cecilsmith/PIC24_Scale/docs/3d/Scale_Lid.obj

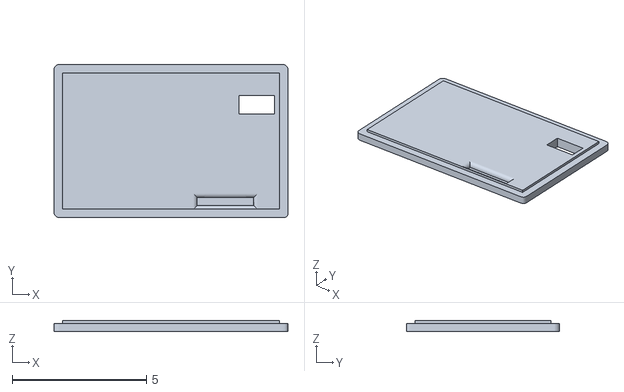
[picture p4: CAD file, 2025-05-07]
docs/3d/Scale_Lid.obj
8.70 x 5.70 x 0.4
