cecilsmith/PIC24_Scale/docs/3d/Scale_Box.obj

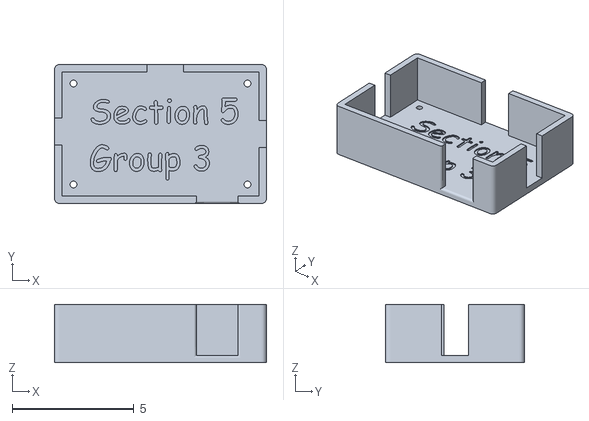
[picture p5: CAD file, 2025-05-07]
docs/3d/Scale_Box.obj
8.70 x 5.70 x 2.40
