cecilsmith/PIC24_Scale/docs/EE3951W_Scale_Schematic.pdf

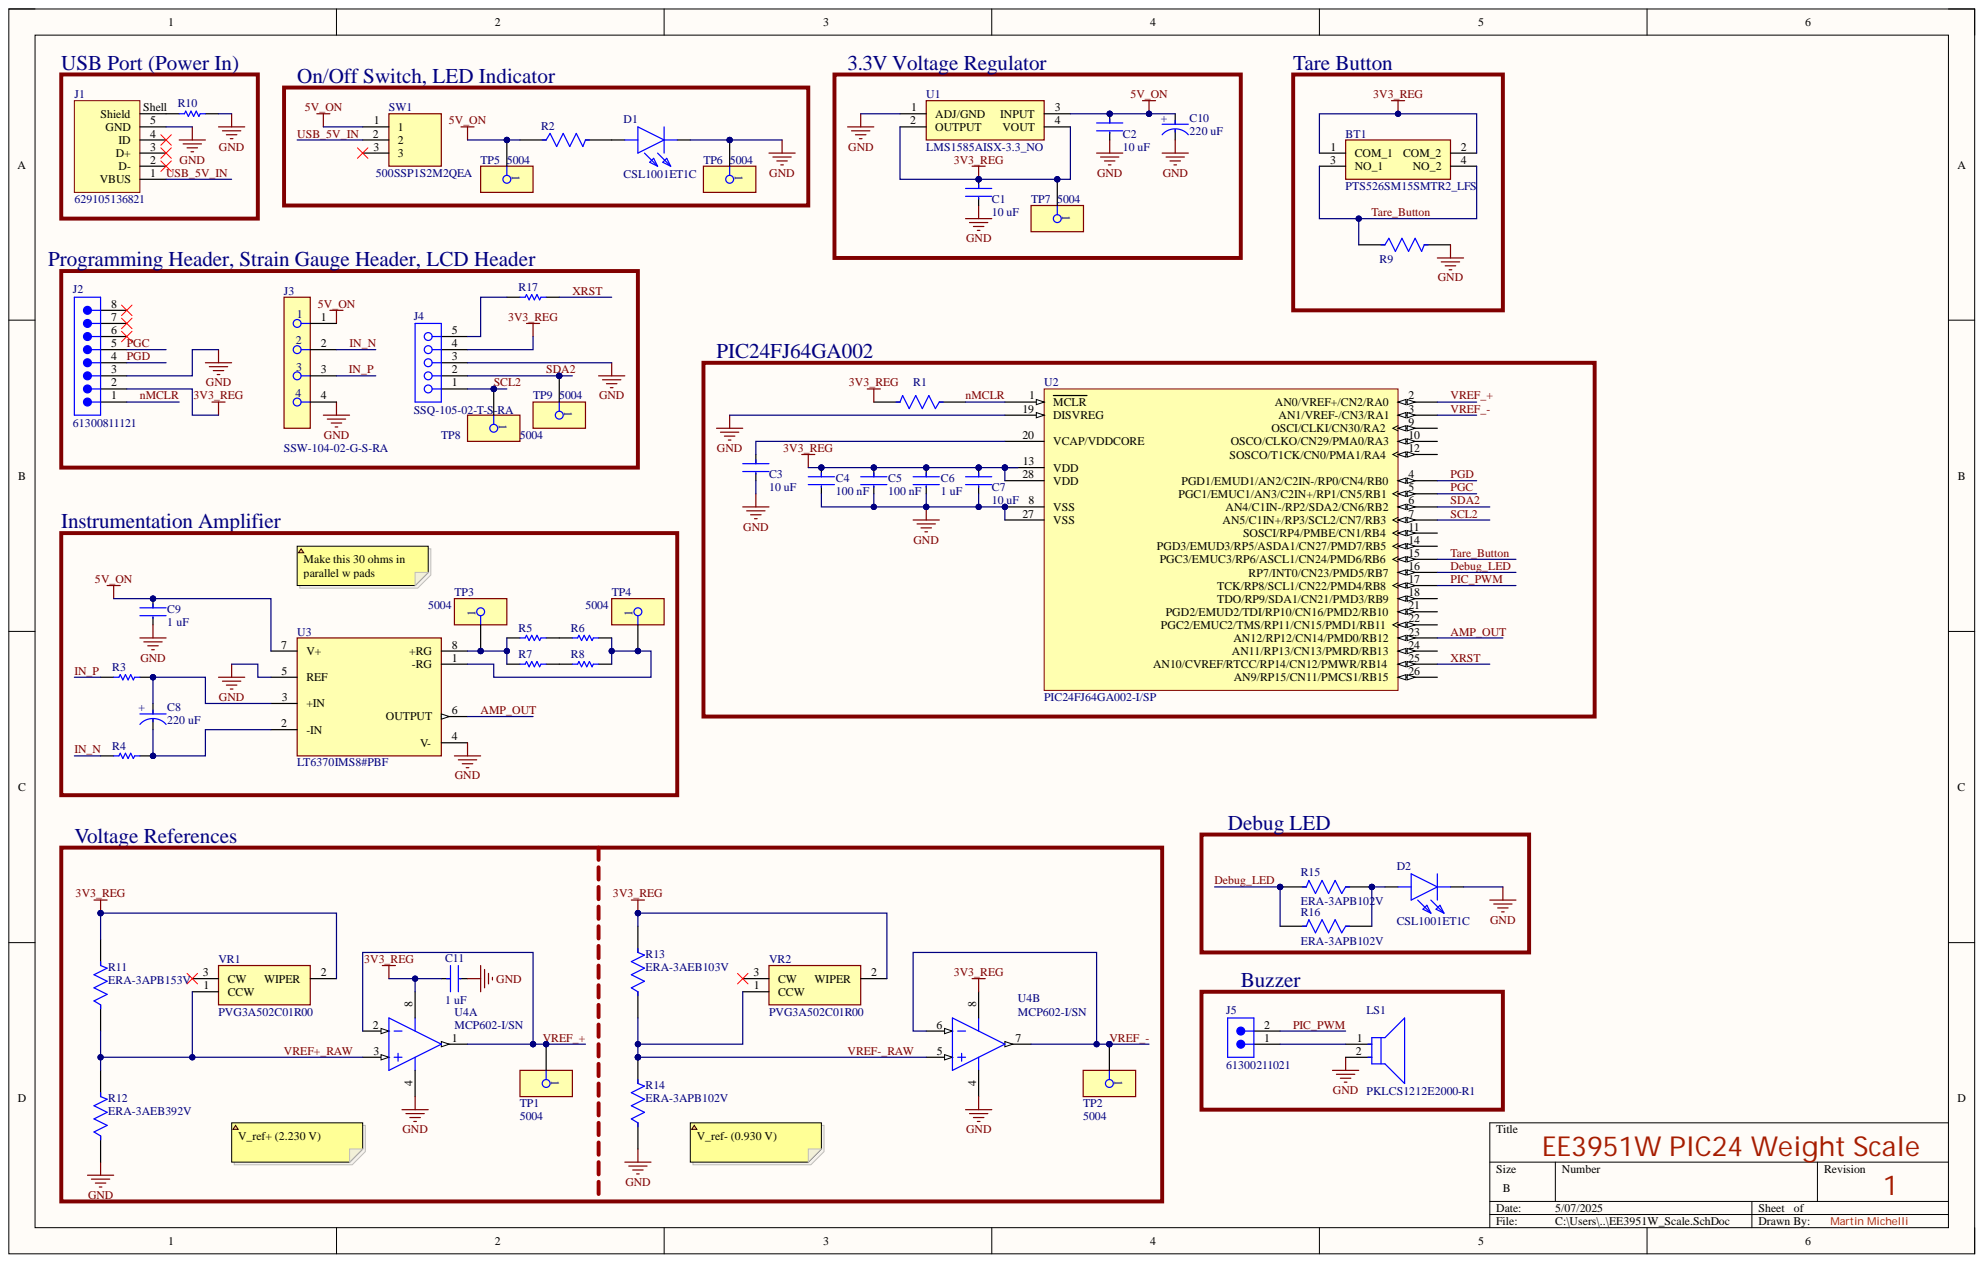
[picture p6: page 1]

USB Port (Power In)

On/Off Switch, LED Indicator

Programming Header, Strain Gauge Header, LCD Header

Make this 30 ohms in
parallel w pads

Size B | Number | Revision 1

Date: 5/07/2025 | Sheet of
File: C:\Users\..\EE3951W_Scale.SchDoc | Drawn By: Martin Michelli
