cecilsmith/PIC24_Scale/docs/EE3951W_Scale_front.pdf

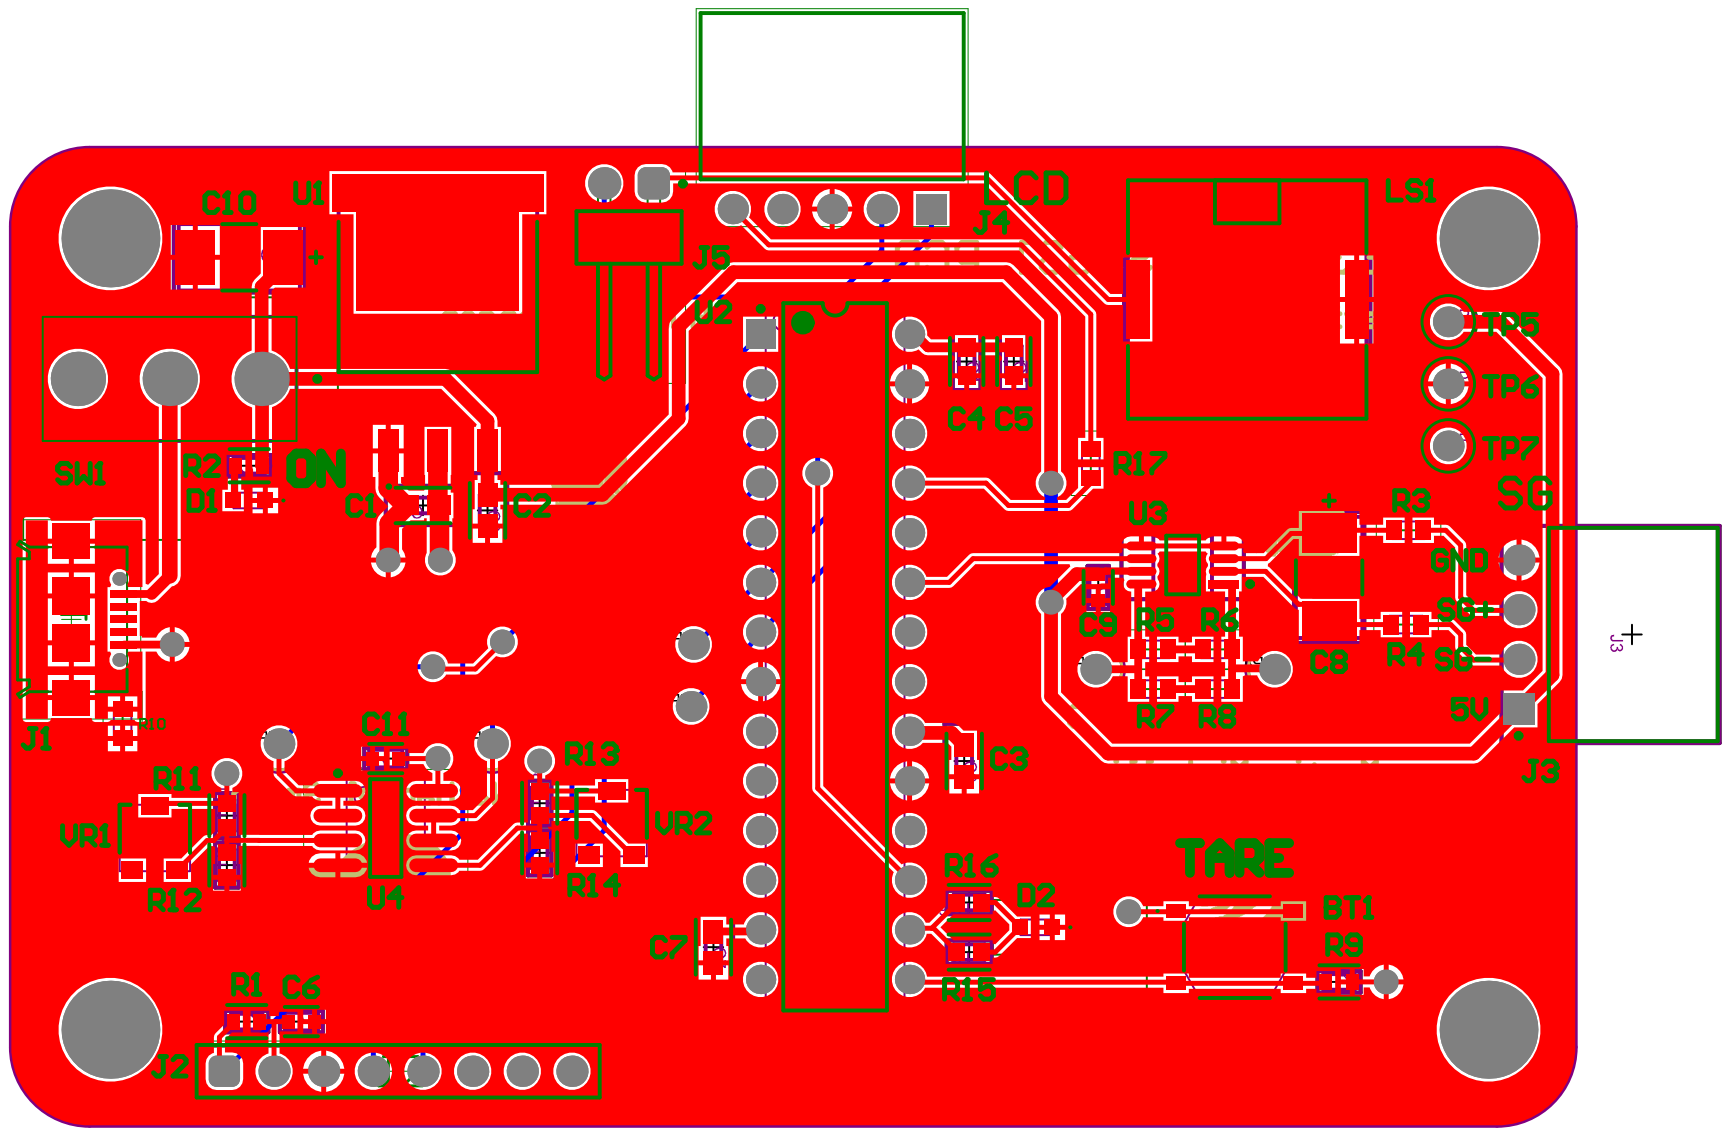
[picture p7: page 1]
