cecilsmith/PIC24_Scale/conversion.h

/* 
 * File:   conversion.h
 * Author: hunte
 *
 * Created on February 26, 2025, 9:55 AM
 */

#ifndef CONVERSION_H
#define	CONVERSION_H

#ifdef	__cplusplus
extern "C" {
#endif

int convWeight();

#ifdef	__cplusplus
}
#endif

#endif	/* CONVERSION_H */
