cecilsmith/PIC24_Scale/(commit log)

2025-02-12 Add files via upload
    Added files, adc, conversion, lcd, and main.
    Main, LCD, and ADC are 90% complete pending testing.
    Conversion is just an outline pending testing for conversion math.
2025-04-25 ADC conversion done
    corrected the sticking issue and made the correct conversion equation. (Fully Work)
    [adc.c, main.c]
2025-04-25 TWO COMMITS IN ONE DAY
    Added working tare functionality. Includes LED confirmation.
2025-05-07 3D files for box and lid
    [Scale_Box.obj, Scale_Lid.obj]
2025-05-07 circuit simulation
